smitra/TicTocTrac/README.txt

/*******************************************************/
/*                  TicTocTrac v1.0                    */
/*             Brian Schiffer & Sima Mitra             */
/*               ECE 4760 Final Project                */
/*                                                     */
/*  Schematics,PCB,3D model licensed under OSHW v1.0   */
/*           http://freedomdefined.org/OSHW            */
/*                                                     */
/*         All code licensed under GNU GPL v3          */
/*******************************************************/

=========================================================
 Project Contents
=========================================================

README.txt - this readme file
gpl-3.0.txt - GNU GPL v3 license copy
hex2bin.exe - tool for converting hex files to bin files
            - Requires hex filename shorter than 8 char
            - Ex: hex2bin tictoc.hex
Case3D - contains the google sketchup files for our case
EagleSchematicsPCB - Eagle Schematics & PCB
SDCardBootloader - bootloader for loading bin from SD
WatchFirmware - the main tictoctrac watch firmware
