smitra/TicTocTrac/(list of files, cad)

Other CAD files:
Case3D/TicTocTracCase.skp
