smitra/TicTocTrac/EagleSchematicsPCB/TicTocTrac_bottom_v1.0.brd

## EAGLE design EagleSchematicsPCB/TicTocTrac_bottom_v1.0.brd (2012-05-03)

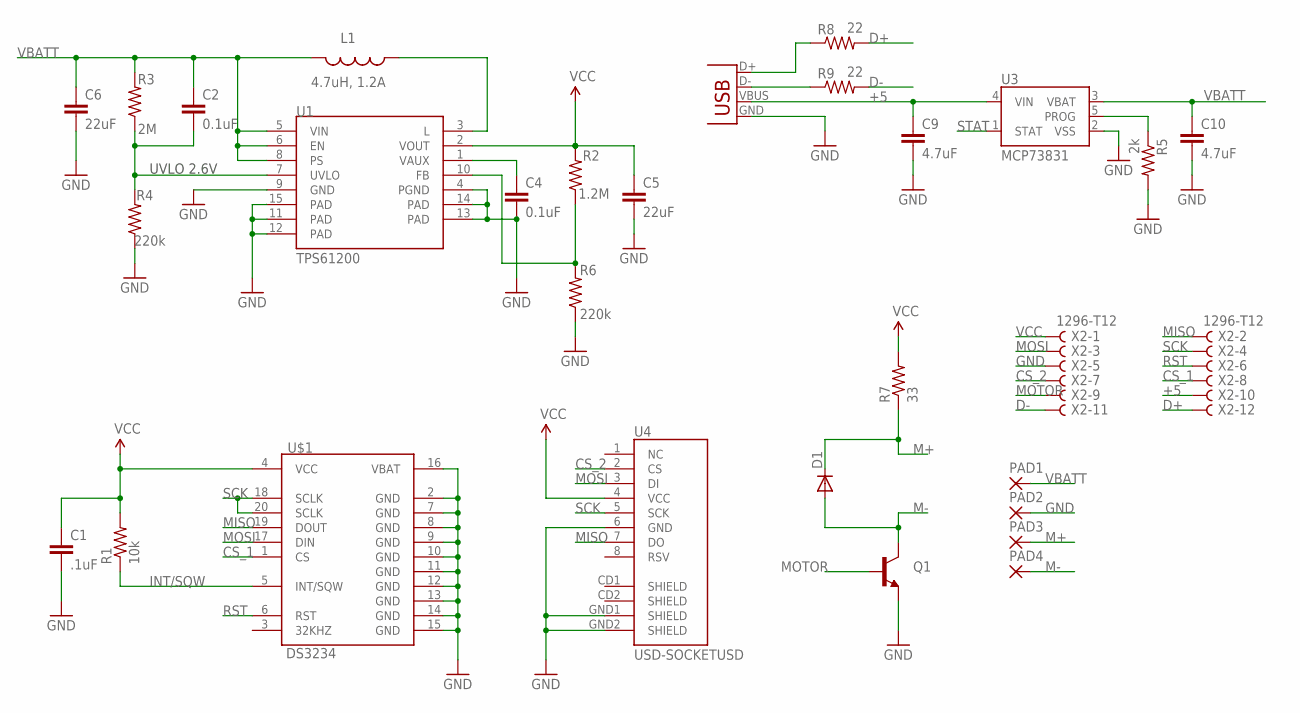
[picture p1: schematic TicTocTrac_bottom_v1.0.sch]

Parts:
C1: .1uF; 0402-CAP
C2, C4: 0.1uF; 0402-CAP
C5, C6: 22uF; 0805
C9, C10: 4.7uF; 0402-CAP
D1: DIODESOD; SOD-323
L1: 4.7uH, 1.2A; CDRH2D09
PAD1, PAD2, PAD3, PAD4: 1,6/0,8
Q1: TRANSISTOR_NPNSOT23; SOT23
R1: 10k; 0402-RES
R2: 1.2M; 0402-RES
R3: 2M; 0402-RES
R4, R6: 220k; 0402-RES
R5: 2k; 0402-RES
R7: 33; 0805
R8, R9: 22; 0402-RES
U1: TPS61200; QFN-10_PAD
U3: MCP73831; SOT23-5
U4: USD-SOCKETUSD; USD-SOCKET-PP
U$1: DS3234
X1: USB-MICROB
X2: 1296-T12; 1296-12

Connections:
3.3V: R2.1, R6.2, U1.10 (FB)
+5: C9.1, U3.4 (VIN), X1.VBUS, X2.10
CS_1: U$1.1 (CS), X2.8
CS_2: U4.2 (CS), X2.7
D+: R8.2, X2.12
D-: R9.2, X2.11
GND: C1.2, C4.2, C5.2, C6.2, C9.2, C10.2, PAD2.1, Q1.2 (E), R4.1, R5.2, R6.1, U1.4 (PGND), U1.11 (PAD), U1.12 (PAD), U1.13 (PAD), U1.14 (PAD), U1.15 (PAD), U3.2 (VSS), U4.6 (GND), U4.GND1 (SHIELD), U4.GND2 (SHIELD), U$1.2 (GND), U$1.7 (GND), U$1.8 (GND), U$1.9 (GND), U$1.10 (GND), U$1.11 (GND), U$1.12 (GND), U$1.13 (GND), U$1.14 (GND), U$1.15 (GND), U$1.16 (VBAT), X1.GND, X2.5
INT/SQW: R1.1, U$1.5 (INT/SQW)
M+: D1.1 (C), PAD3.1, R7.1
M-: D1.2 (A), PAD4.1, Q1.3 (C)
MISO: U4.7 (DO), U$1.19 (DOUT), X2.2
MOSI: U4.3 (DI), U$1.17 (DIN), X2.3
MOTOR: Q1.1 (B), X2.9
unnamed: C4.1, U1.1 (VAUX)
unnamed: L1.P$1 (1), U1.3 (L)
unnamed: R9.1, X1.D-
unnamed: R8.1, X1.D+
unnamed: R5.1, U3.5 (PROG)
RST: U$1.6 (RST), X2.6
SCK: U4.5 (SCK), U$1.18 (SCLK), U$1.20 (SCLK), X2.4
STAT: U3.1 (STAT)
UVLO: C2.2, R3.1, R4.2, U1.7 (UVLO)
VBATT: C2.1, C6.1, C10.1, L1.P$2 (2), PAD1.1, R3.2, U1.5 (VIN), U1.6 (EN), U1.8 (PS), U3.3 (VBAT)
VCC: C1.1, C5.1, R1.2, R2.2, R7.2, U1.2 (VOUT), U4.4 (VCC), U$1.4 (VCC), X2.1

Notes on the sheet:
UVLO 2.6V

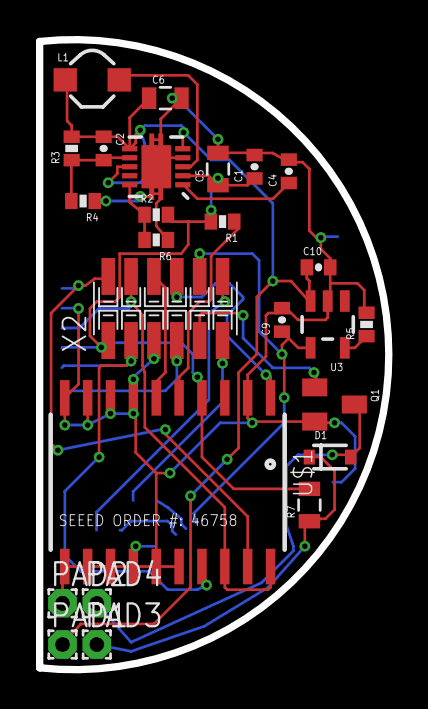
[picture p2: board TicTocTrac_bottom_v1.0.brd from above]

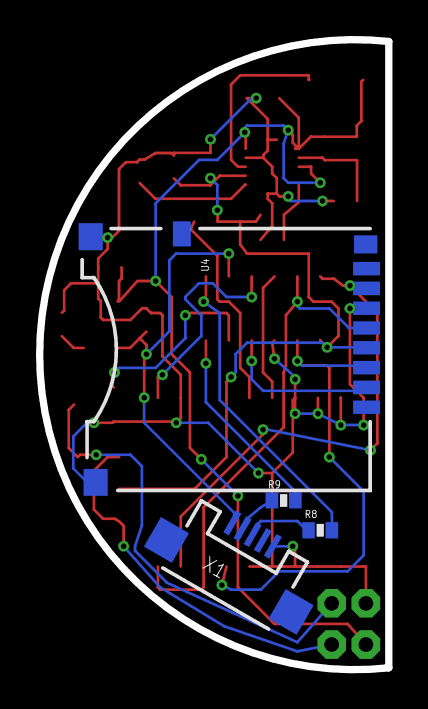
[picture p3: board TicTocTrac_bottom_v1.0.brd from below]

Board: 2 copper layers, 19.4 x 35.0 mm, 29 parts (4 on the bottom side), 23 nets.
