smitra/TicTocTrac/EagleSchematicsPCB/TicTocTrac_top_v1.0.brd

## EAGLE design EagleSchematicsPCB/TicTocTrac_top_v1.0.brd (2012-05-03)

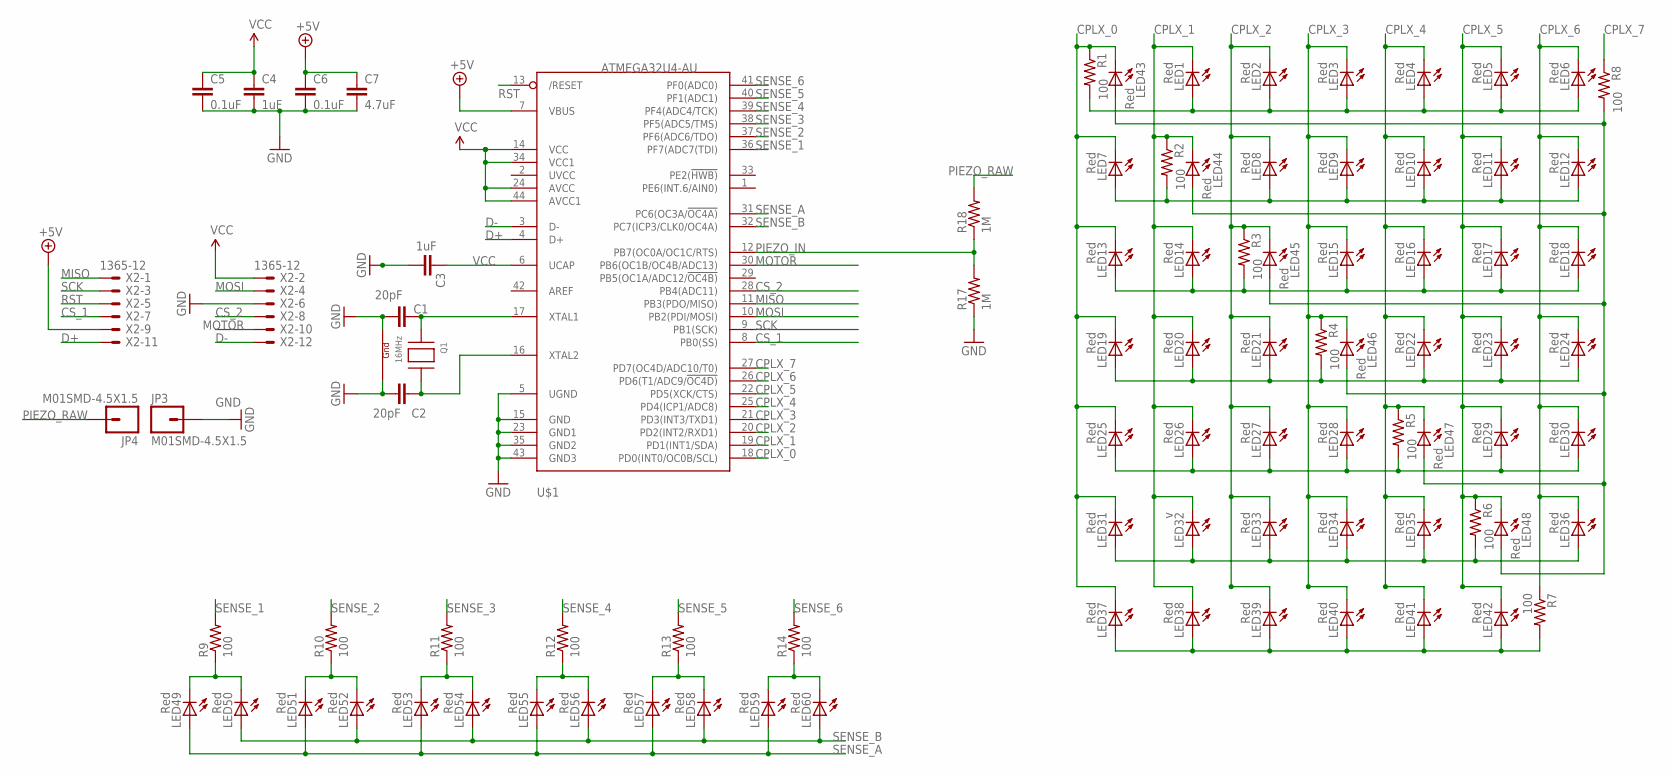
[picture p4: schematic TicTocTrac_top_v1.0.sch]

Parts:
C1, C2: 20pF; 0402-CAP
C3, C4: 1uF; 0402-CAP
C5, C6: 0.1uF; 0402-CAP
C7: 4.7uF; 0402-CAP
JP3, JP4: M01SMD-4.5X1.5; PAD-1.5X4.5
LED1, LED2, LED3, LED4, LED5, LED6, LED7, LED8, LED9, LED10, LED11, LED12, LED13, LED14, LED15, LED16, LED17, LED18, LED19, LED20, LED21, LED22, LED23, LED24, LED25, LED26, LED27, LED28, LED29, LED30, LED31, LED33, LED34, LED35, LED36, LED37, LED38, LED39, LED40, LED41, LED42, LED43, LED44, LED45, LED46, LED47, LED48, LED49, LED50, LED51, LED52, LED53, LED54, LED55, LED56, LED57, LED58, LED59, LED60: Red; LED-0603
LED32: v; LED-0603
Q1: 16MHz; NX3225
R1, R2, R3, R4, R5, R6, R7, R8, R9, R10, R11, R12, R13, R14: 100; 0402-RES
R17, R18: 1M; 0805
U$1: ATMEGA32U4-AU; TQFP44
X2: 1365-12

Connections:
+5V: C6.1, C7.1, U$1.7 (VBUS), X2.9
CPLX_0: LED7.C, LED13.C, LED19.C, LED25.C, LED31.C, LED37.C, LED43.C, R1.1, U$1.18 (PD0(INT0/OC0B/SCL))
CPLX_1: LED1.C, LED14.C, LED20.C, LED26.C, LED32.C, LED38.C, LED44.C, R2.1, U$1.19 (PD1(INT1/SDA))
CPLX_2: LED2.C, LED8.C, LED21.C, LED27.C, LED33.C, LED39.C, LED45.C, R3.1, U$1.20 (PD2(INT2/RXD1))
CPLX_3: LED3.C, LED9.C, LED15.C, LED28.C, LED34.C, LED40.C, LED46.C, R4.1, U$1.21 (PD3(INT3/TXD1))
CPLX_4: LED4.C, LED10.C, LED16.C, LED22.C, LED35.C, LED41.C, LED47.C, R5.1, U$1.25 (PD4(ICP1/ADC8))
CPLX_5: LED5.C, LED11.C, LED17.C, LED23.C, LED29.C, LED42.C, LED48.C, R6.1, U$1.22 (PD5(XCK/CTS))
CPLX_6: LED6.C, LED12.C, LED18.C, LED24.C, LED30.C, LED36.C, R7.1, U$1.26 (PD6(T1/ADC9/!OC4D))
CPLX_7: R8.1, U$1.27 (PD7(OC4D/ADC10/T0))
CS_1: U$1.8 (PB0(SS)), X2.7
CS_2: U$1.28 (PB4(ADC11)), X2.8
D+: U$1.4 (D+), X2.11
D-: U$1.3 (D-), X2.12
GND: C1.2, C2.2, C3.2, C4.2, C5.2, C6.2, C7.2, JP3.P$1, Q1.2 (G2), Q1.4 (G1), R17.1, U$1.5 (UGND), U$1.15 (GND), U$1.23 (GND1), U$1.35 (GND2), U$1.43 (GND3), X2.6
MISO: U$1.11 (PB3(PDO/MISO)), X2.1
MOSI: U$1.10 (PB2(PDI/MOSI)), X2.4
MOTOR: U$1.30 (PB6(OC1B/OC4B/ADC13)), X2.10
unnamed: C2.1, Q1.3 (X2), U$1.16 (XTAL2)
unnamed: C1.1, Q1.1 (X1), U$1.17 (XTAL1)
unnamed: LED19.A, LED20.A, LED21.A, LED22.A, LED23.A, LED24.A, R4.2
unnamed: LED1.A, LED2.A, LED3.A, LED4.A, LED5.A, LED6.A, R1.2
unnamed: LED7.A, LED8.A, LED9.A, LED10.A, LED11.A, LED12.A, R2.2
unnamed: LED25.A, LED26.A, LED27.A, LED28.A, LED29.A, LED30.A, R5.2
unnamed: LED13.A, LED14.A, LED15.A, LED16.A, LED17.A, LED18.A, R3.2
unnamed: LED43.A, LED44.A, LED45.A, LED46.A, LED47.A, LED48.A, R8.2
unnamed: LED37.A, LED38.A, LED39.A, LED40.A, LED41.A, LED42.A, R7.2
unnamed: LED31.A, LED32.A, LED33.A, LED34.A, LED35.A, LED36.A, R6.2
unnamed: LED49.C, LED50.C, R9.1
unnamed: LED51.C, LED52.C, R10.1
unnamed: LED53.C, LED54.C, R11.1
unnamed: LED55.C, LED56.C, R12.1
unnamed: LED57.C, LED58.C, R13.1
unnamed: LED59.C, LED60.C, R14.1
PIEZO_IN: R17.2, R18.1, U$1.12 (PB7(OC0A/OC1C/RTS))
PIEZO_RAW: JP4.P$1, R18.2
RST: U$1.13 (/RESET), X2.5
SCK: U$1.9 (PB1(SCK)), X2.3
SENSE_1: R9.2, U$1.36 (PF7(ADC7(TDI))
SENSE_2: R10.2, U$1.37 (PF6(ADC6/TDO))
SENSE_3: R11.2, U$1.38 (PF5(ADC5/TMS))
SENSE_4: R12.2, U$1.39 (PF4(ADC4/TCK))
SENSE_5: R13.2, U$1.40 (PF1(ADC1))
SENSE_6: R14.2, U$1.41 (PF0(ADC0))
SENSE_A: LED49.A, LED51.A, LED53.A, LED55.A, LED57.A, LED59.A, U$1.31 (PC6(OC3A/!OC4A))
SENSE_B: LED50.A, LED52.A, LED54.A, LED56.A, LED58.A, LED60.A, U$1.32 (PC7(ICP3/CLK0/OC4A))
VCC: C3.1, C4.1, C5.1, U$1.6 (UCAP), U$1.14 (VCC), U$1.24 (AVCC), U$1.34 (VCC1), U$1.44 (AVCC1), X2.2

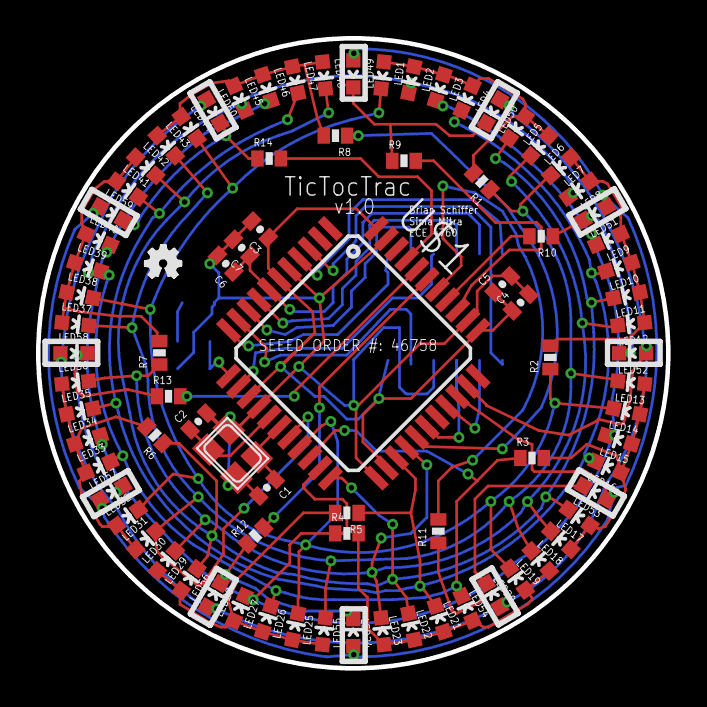
[picture p5: board TicTocTrac_top_v1.0.brd from above]

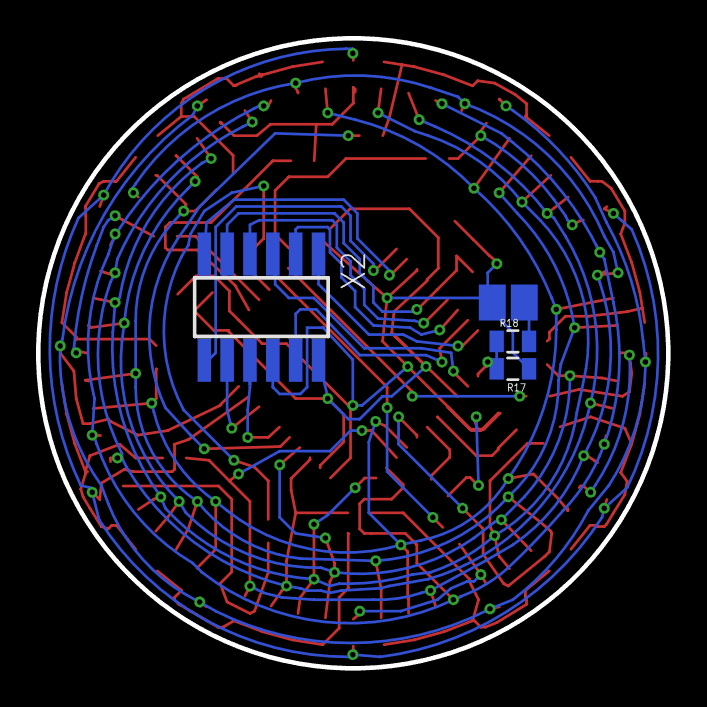
[picture p6: board TicTocTrac_top_v1.0.brd from below]

Board: 2 copper layers, 35.0 x 35.0 mm, 89 parts (5 on the bottom side), 46 nets.

Other parts of the board:
U$2: OSHW_FILLX70_NOTEXT
