smitra/TicTocTrac/(commit log)

2012-05-03 Updating github
    [TicTocTracCase.skp]
2012-05-03 Added TicTocTrac v1.0 including: -Eagle Files -C code -3D case -SD card bootloader
    [TicTocTrac_bottom_v1.0.brd, TicTocTrac_bottom_v1.0.sch, TicTocTrac_top_v1.0.brd, TicTocTrac_top_v1.0.sch]
